eutectic6337/615-labs-SAO/artwork/readme.md

## SVG Layers

### Layers
Front
- frnt_soldermask.svg (background)
- frnt_fiberglass.svg (liquid & bubbles)
- frnt_tin-trace.svg (flask outline/ internal city silhouette/ lettering)

Back
- back_soldermask.svg (background)
- back_fiberglass.svg (liquid w/ detail(shine through method); mirrored bubbles)
- back_tin-trace.svg (lettering)

### Notes:
- Footprint for existing surface mount SAO for reference: 9mmx8mm (Need this as the fiberglass portion of this SAO may need to be adjusted in the graphic to fit the footprints for male SAO connector)
- Since these will likely be advertisements for 615-labs / swag trade / or freebies and we're trying to limit multi-color soldermask, the layering on the SVGs may look odd; however, I think it will give the bubbles and the liquid in the erlenmeyer enough contrasting depth with the green lights to each a 'detailed' ~enough 8-bit effect
- Noto Sans Mono is the Font for our original logo
