eutectic6337/615-labs-SAO/production/bom.csv

Designator | Footprint | Quantity | Value | LCSC Part #
C1 | 0603 | 1 | 2.2uF
LED1, LED2, LED3, LED4, LED5, LED6, LED7, LED8 | LED1206-FD_GREEN-EH | 8 | green
R1, R2, R3, R4, R5, R6, R7, R8 | 0402 | 8 | 22R
U1 | QFN-20-1EP_3x3mm_P0.4mm_EP1.65x1.65mm_ThermalVias | 1 | WCH CH32V003F4U6
X1 | IDC-Header_2x03_P2.54mm_Vertical_SMD | 1 | Simple_Addon_v2
