eutectic6337/615-labs-SAO/615-labs-SAO.kicad_pcb

## KiCad design 615-labs-SAO.kicad_pcb (2026-07-01)

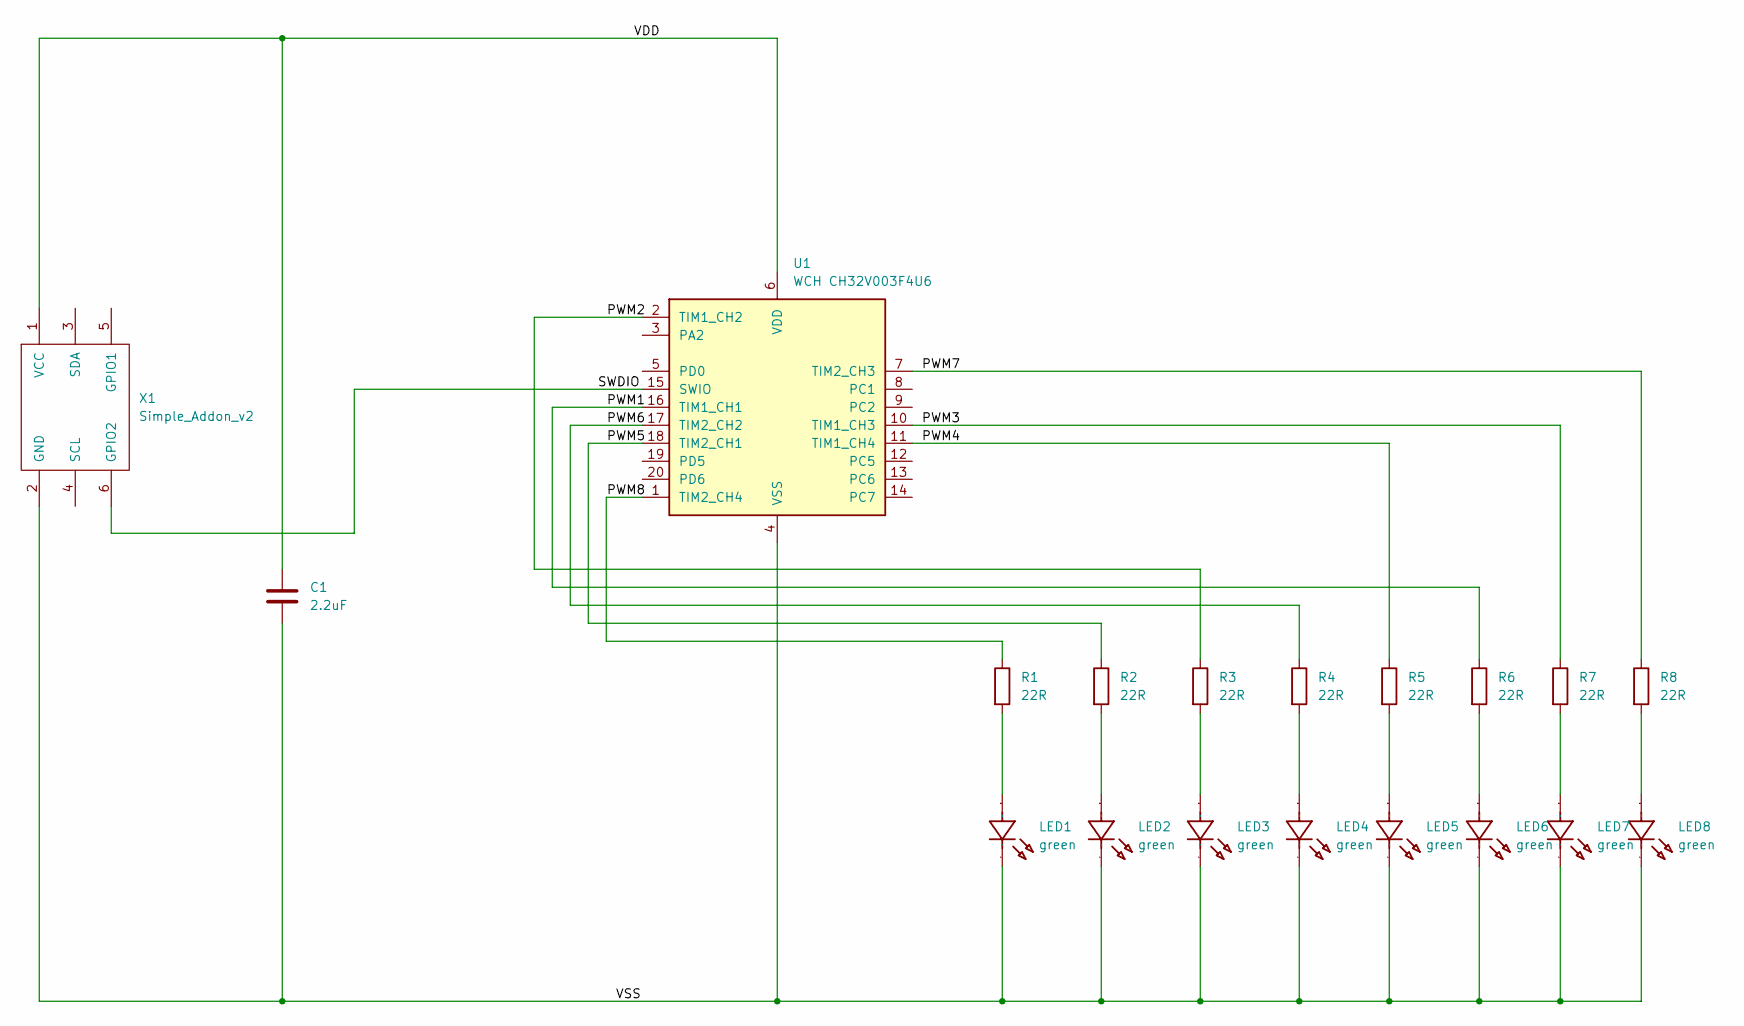
[picture p1: schematic 615-labs-SAO.kicad_sch]

Parts:
C1: 2.2uF; C_0603_1608Metric
LED1, LED2, LED3, LED4, LED5, LED6, LED7, LED8: green; LED1206-FD_GREEN-EH; Manufacturer Part XL-3216UGC-FB; LCSC Part Name 1206翠绿（反编）贴片式发光二极管
R1, R2, R3, R4, R5, R6, R7, R8: 22R; R_0402_1005Metric
U1: WCH CH32V003F4U6; QFN-20-1EP_3x3mm_P0.4mm_EP1.65x1.65mm_ThermalVias
X1: Simple_Addon_v2; IDC-Header_2x03_P2.54mm_Vertical_SMD

Connections:
/PWM1: R6.1, U1.16 (TIM1_CH1)
/PWM2: R3.1, U1.2 (TIM1_CH2)
/PWM3: R7.1, U1.10 (TIM1_CH3)
/PWM4: R5.1, U1.11 (TIM1_CH4)
/PWM5: R2.1, U1.18 (TIM2_CH1)
/PWM6: R4.1, U1.17 (TIM2_CH2)
/PWM7: R8.1, U1.7 (TIM2_CH3)
/PWM8: R1.1, U1.1 (TIM2_CH4)
/SWDIO: U1.15 (SWIO), X1.6 (GPIO2)
/VDD: C1.1, U1.6 (VDD), X1.1 (VCC)
unnamed: LED1.1 (A), R1.2
unnamed: LED2.1 (A), R2.2
unnamed: LED3.1 (A), R3.2
unnamed: LED4.1 (A), R4.2
unnamed: LED5.1 (A), R5.2
unnamed: LED6.1 (A), R6.2
unnamed: LED7.1 (A), R7.2
unnamed: LED8.1 (A), R8.2
VSS: C1.2, LED1.2 (K), LED2.2 (K), LED3.2 (K), LED4.2 (K), LED5.2 (K), LED6.2 (K), LED7.2 (K), LED8.2 (K), U1.4 (VSS), U1.21 (VSS), X1.2 (GND)

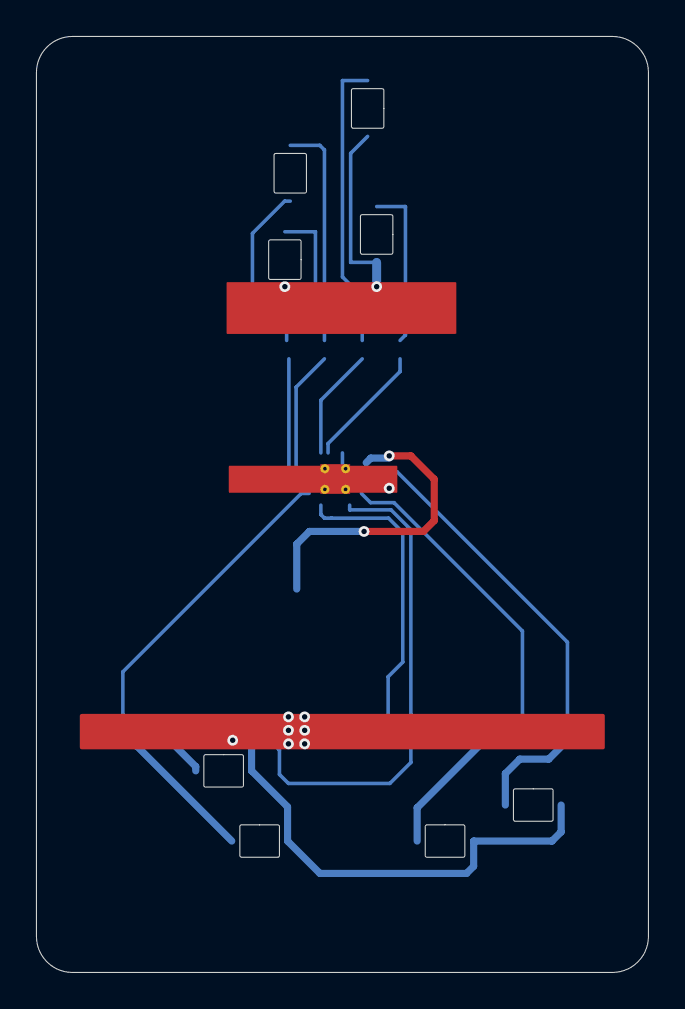
[picture p2: board 615-labs-SAO.kicad_pcb from above]

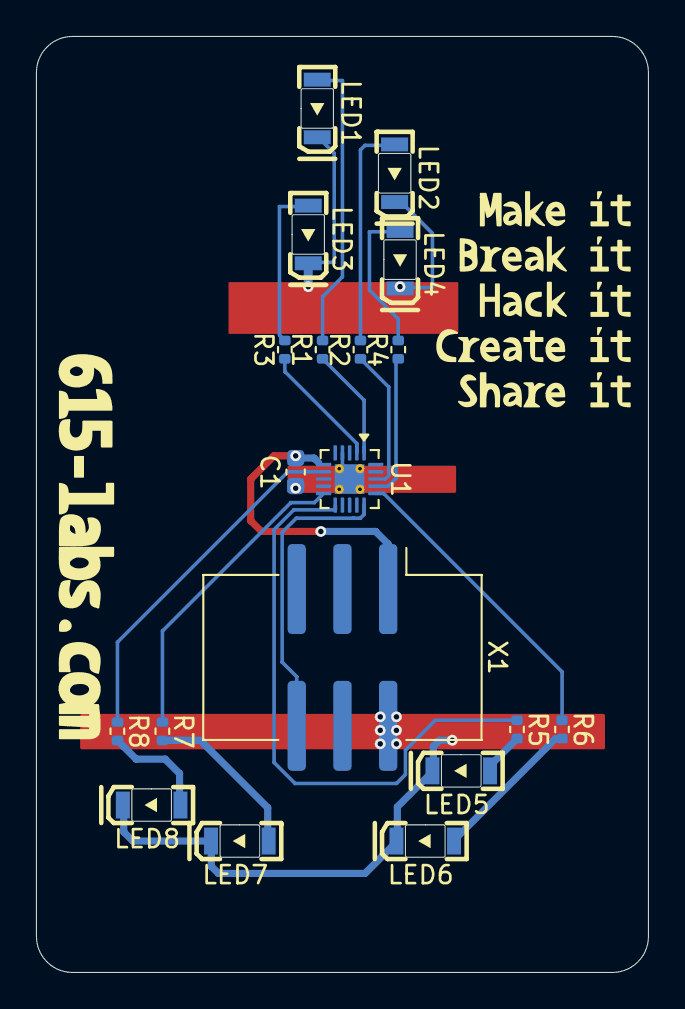
[picture p3: board 615-labs-SAO.kicad_pcb from below]

Board: 2 copper layers, 34.0 x 52.0 mm, 19 parts (19 on the bottom side), 19 nets.
