eutectic6337/615-labs-SAO/(commit log)

2026-05-31 start schematic and PCB, and document
    [615-labs-SAO.kicad_pcb, 615-labs-SAO.kicad_sch]
2026-06-01 Add notes on SAO footprint to readme
    Added notes regarding the footprint for the existing surface mount SAO.
2026-06-12 got QFN footprint, placed art
    [615-labs-SAO.kicad_pcb, 615-labs-SAO.kicad_sch]
2026-06-21 generated fab files
    [615-labs-SAO.kicad_pcb, 615-labs-SAO.kicad_sch, bom.csv, positions.csv]
2026-06-21 rounded the corners
    [615-labs-SAO.kicad_pcb]
2026-06-28 correct SAO connector footprint
    [615-labs-SAO.kicad_pcb, 615-labs-SAO.kicad_sch, bom.csv, positions.csv]
2026-06-30 use EasyEDA footprint for reverse-mount LED
    [615-labs-SAO.kicad_pcb, 615-labs-SAO.kicad_sch, bom.csv, positions.csv]
2026-07-01 re-route around LED cutouts
    [615-labs-SAO.kicad_pcb]
2026-07-13 document LED-pin assignments
2026-07-31 Add Erlenmeyer Flask animation implementation
    This file contains the complete implementation of the Erlenmeyer Flask animation using LEDs, including bubble and liquid dynamics, PWM settings, and GPIO configurations.
